robotoroberto01/gello/docs/gello-home-2026-09-05.png

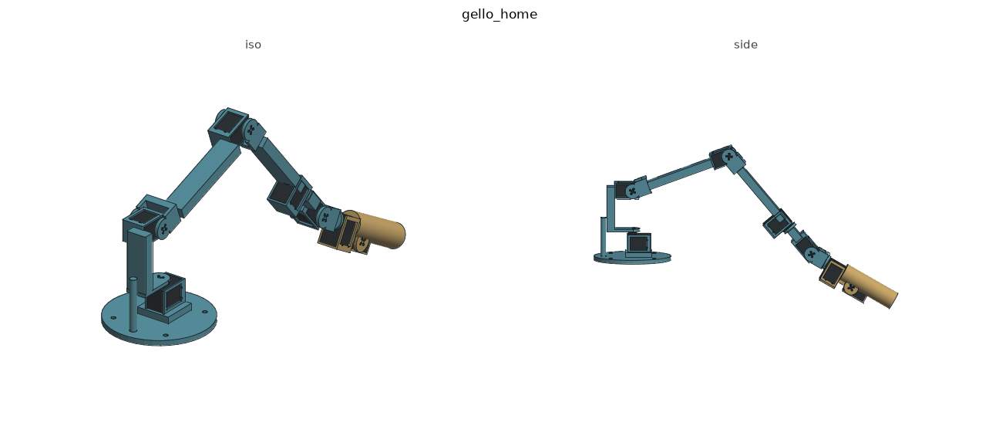
docs/gello-home-2026-09-05.png
