robotoroberto01/gello/docs/bom.md

# Bill of materials (5 September 2026)

## Buy (~$250)

| item | qty | ~$ | source |
|---|---|---|---|
| DYNAMIXEL XL330-M288-T | 7 | 192 | robotis.us (the XC330 at $100 is the same case; not needed for a leader) |
| ROBOTIS X3P cable pack, 180 mm x 10 | 1 | 10 | robotis.us; ships with the servos |
| ESP32-S3-DevKitC-1-N16R8 | 1 | 10 | Amazon (the 09-04 3-pack has no spare) |
| M2 x 6 and M2 x 8 screws + nuts (the servos ship with a few) | 40 | 6 | or the M2 x 6 pack in the arm's McMaster cart |
| M3 x 8 + nylocs, idler pivots | 3 | | Glarks kit |
| rubber bands, a small spring for the trigger | | | household |
| USB-C cable, 2 m | 1 | | in hand |

## Have

| item | from |
|---|---|
| 74AHCT125 x 10 | DigiKey order 09-04 |
| PETG (or PLA) ~150 g | the arm's spools |
| 5 V from USB | |

## Printed (`uv run python -m cad.gello`)

| part | mass (PETG, 40 %) |
|---|---|
| base | 44 g |
| shoulder | 12 g |
| upper arm | 24 g |
| forearm | 24 g |
| wrist | 5 g |
| tool | 7 g |
| handle + trigger lever | 29 g |
