robotoroberto01/gello/(commit log)

2026-09-05 GELLO leader arm design: half-scale parametric CAD, node firmware, reader, calibration, brief and BOM
    Seven XL330s (six joints + trigger) on printed links with the RobotDoctor arm's kinematics at 0.5;
    yokes on horn and idler at the pitch joints, J6 mounted inverted in the grip. ESP32-S3 + 74AHCT125
    node streams positions at 100 Hz; gello/ parses, calibrates and rate-limits them into arm targets.
    Fold limits computed by sweeping the assembly (J2 20..200, J3 and J5 +/-110).
    [follow.py, gello.py, gello_node.ino, params.py, protocol.py, reader.py]
2026-10-05 Two corrections from the bridge: no XL330 is ordered yet; Gello's 5 V is USB, not the D36V50F5 (#1)
    From ~/Desktop/claude-openai-bridge/claude-to-openai.md (reply 001, section 1).
    - cad/servos.py: the docstring said the XL330-M288-T was "bought for this". No XL330 order exists; Gello needs
    7 (six joints + trigger) from robotis.us plus its own X3P 180 mm cable pack. The XC330s on order are the
    hand's; do not borrow them.
    - firmware/gello_node/gello_node.ino: the wiring comment named the Pololu D36V50F5 as a 5 V source. That unit is
    hand 3's. Gello's 5 V is USB: the Mac's USB-C into the DevKitC-1, its 5V pin to the bus, no regulator.
    Nothing else in the design is touched.
    Co-authored-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
    [gello_node.ino, servos.py]
